mperaza0714/sea_grant/Assembly/front_angled.png

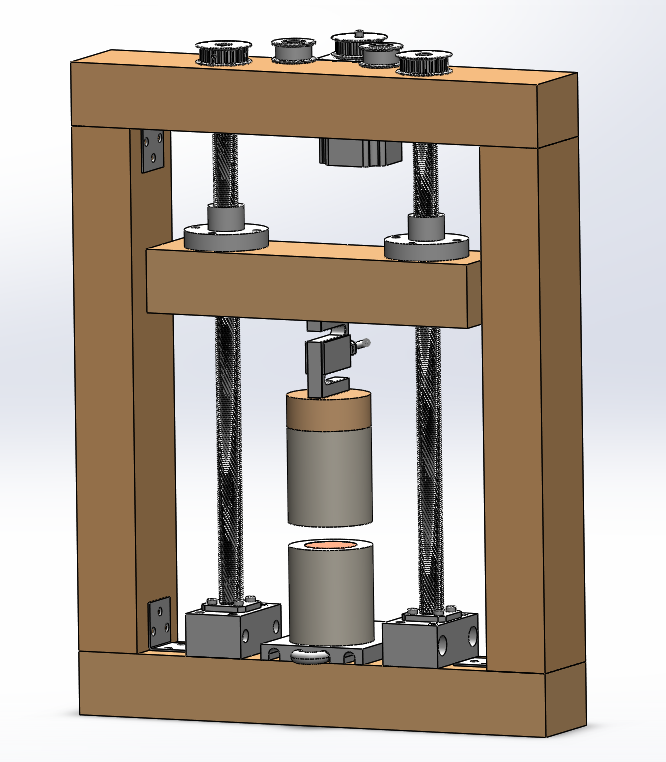
Assembly/front_angled.png
