mperaza0714/sea_grant/Assembly/rod_mount.png

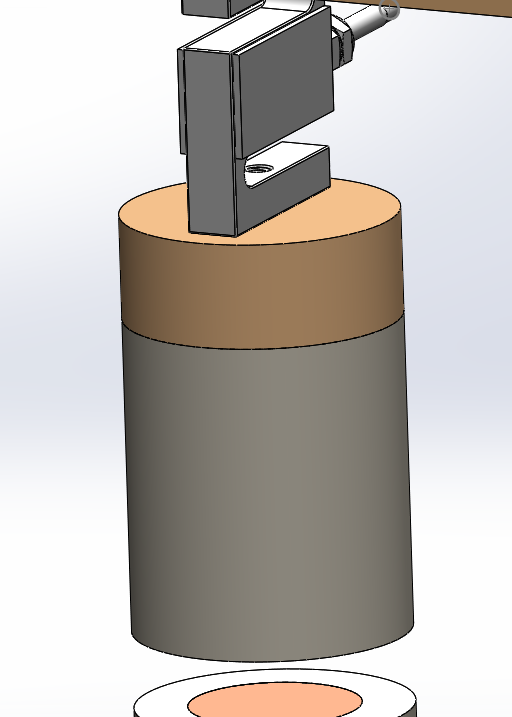
Assembly/rod_mount.png
