mperaza0714/sea_grant/Circuit Diagram.PNG

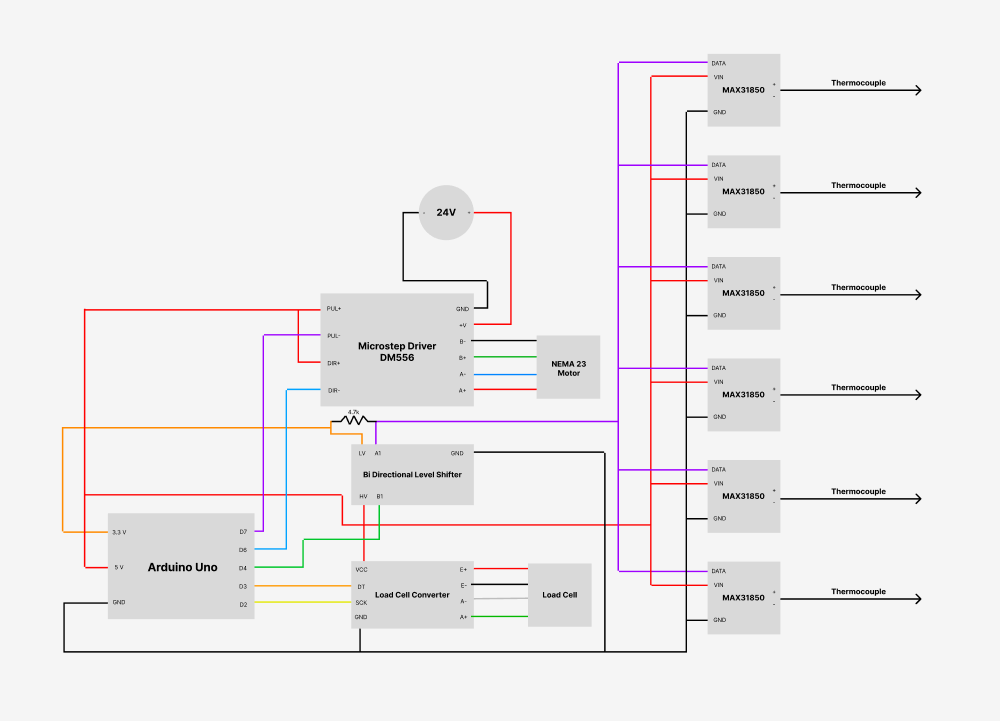
Circuit Diagram.PNG
