mperaza0714/sea_grant/Photos/Moving Platform.PNG

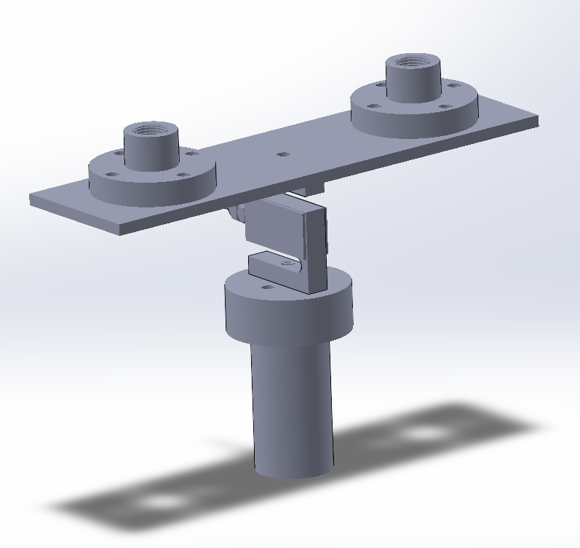
Photos/Moving Platform.PNG
