mperaza0714/sea_grant/Screenshot 2022-07-21 023725.png

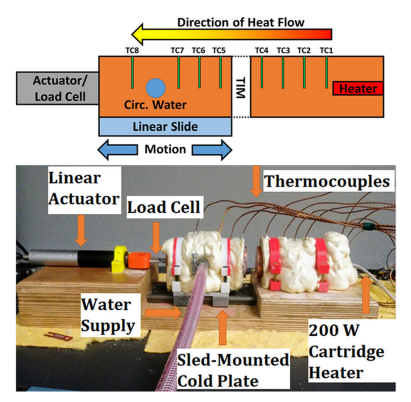
Screenshot 2022-07-21 023725.png
