mperaza0714/sea_grant/Thermal Interface Material Tester Experiments.docx

Thermal Interface Material Tester Experiments

I. Thermal Conductivity of materials given varying Pressure
  a. The material will be subject to varying pressures that can be repeated over several cycles to determine if there is a change in Thermal Conductivity given repeated usage of the material.
II. Thermal Conductivity of materials given static Pressure over Time
  a. Static pressure will be applied to the material where the Thermal Conductivity can be measured over time.
III. Compression Test
  a. Determines a materials behavior under applied loads. Can be used to find yield strength and other material properties.
