mperaza0714/sea_grant/Assembly/frame.SLDASM

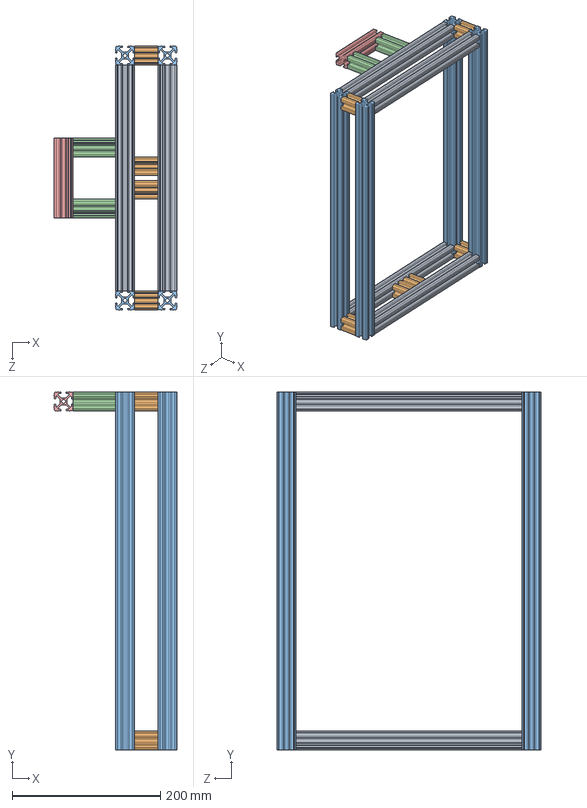
[picture p6: CAD file, 2022-09-02]
Assembly/frame.SLDASM
165.4 x 482.6 x 355.6 mm
T-Slotted Framing_baselength x 4
T-Slotted Framing_basewidth x 6
T-Slotted Framing_height x 4
T-Slotted Framing_motor_width x 2
T-Slotted Framing_motor_length
