mperaza0714/sea_grant/Assembly/moving_platform.SLDASM

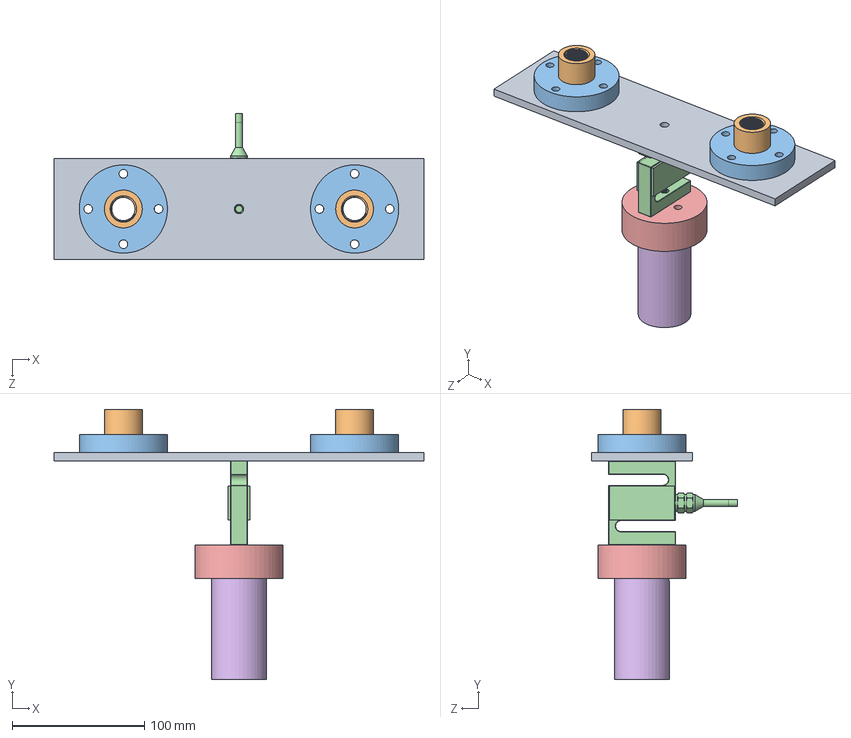
[picture p7: CAD file, 2022-09-02]
Assembly/moving_platform.SLDASM
279.4 x 204.0 x 110.2 mm
moving_platform
3-4_ScrewNut x 2
3-4_ScrewFlange x 2
3487N268_Force Sensor
rod_top
aluminum_rod_top
