mperaza0714/sea_grant/Assembly/cooling_system.SLDASM

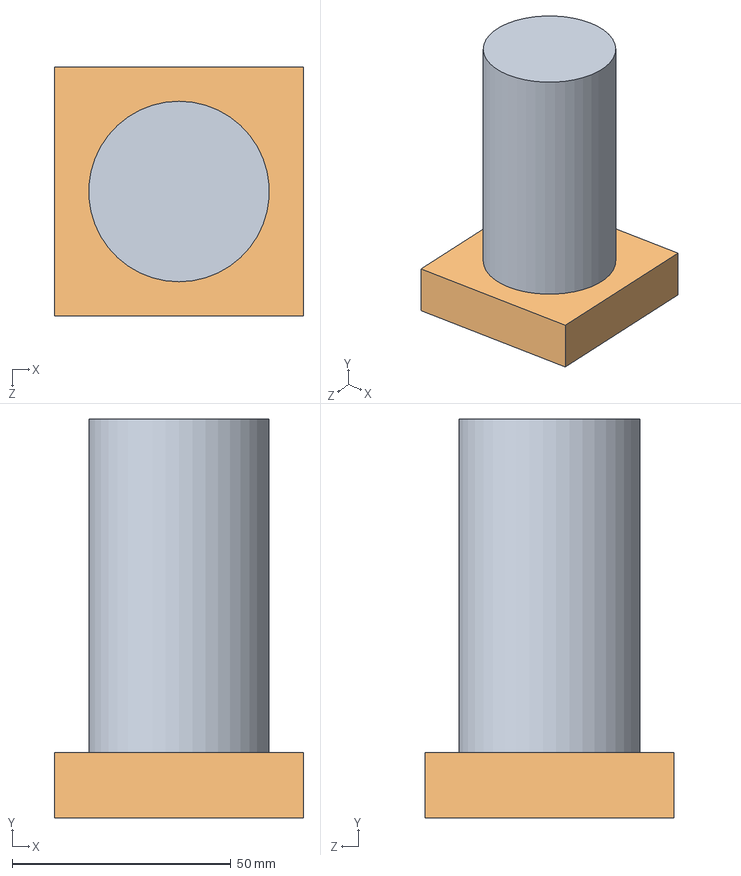
[picture p8: CAD file, 2022-09-02]
Assembly/cooling_system.SLDASM
57.0 x 91.2 x 57.0 mm
aluminum_rod_bottom
cold_plate
