mperaza0714/sea_grant/Assembly/insulated_rod.SLDASM

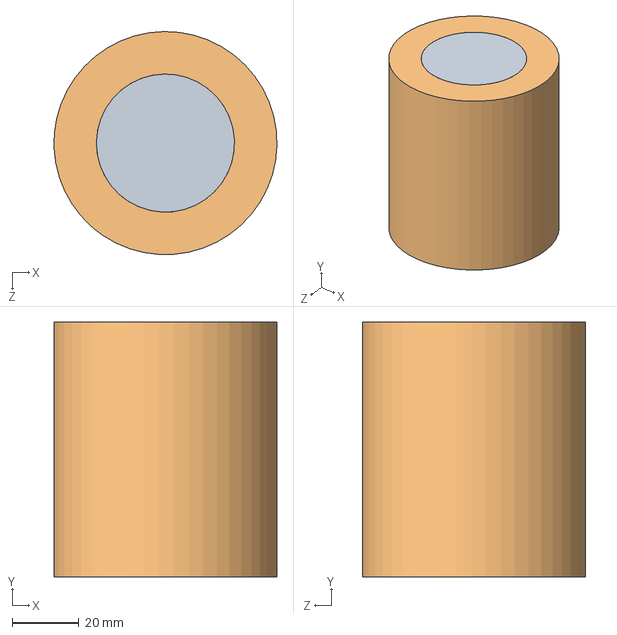
[picture p9: CAD file, 2022-06-21]
Assembly/insulated_rod.SLDASM
66.6 x 76.2 x 66.6 mm
copper_rod
insulation
