mperaza0714/sea_grant/Assembly/Waterjet/moving_platform.DXF

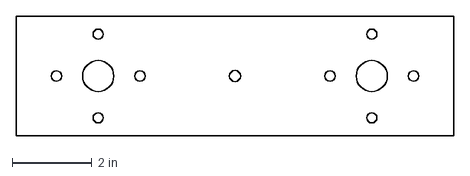
[picture p10: CAD file, 2022-09-02]
Assembly/Waterjet/moving_platform.DXF
11.0 x 3.00 in
