mperaza0714/sea_grant/Assembly/Waterjet/lead_shaft_support.DXF

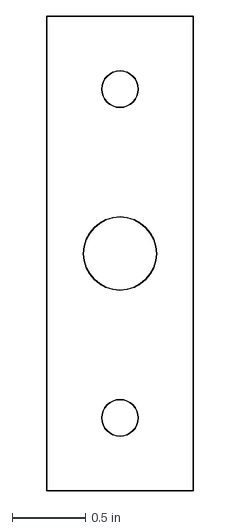
[picture p11: CAD file, 2022-09-02]
Assembly/Waterjet/lead_shaft_support.DXF
1.00 x 3.25 in
