mperaza0714/sea_grant/Assembly/Waterjet/BearingMount.DXF

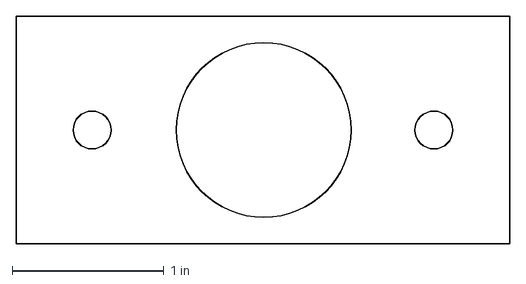
[picture p12: CAD file, 2022-09-02]
Assembly/Waterjet/BearingMount.DXF
3.25 x 1.50 in
