mperaza0714/sea_grant/Assembly/T-Slotted Framing_motor_length.SLDPRT

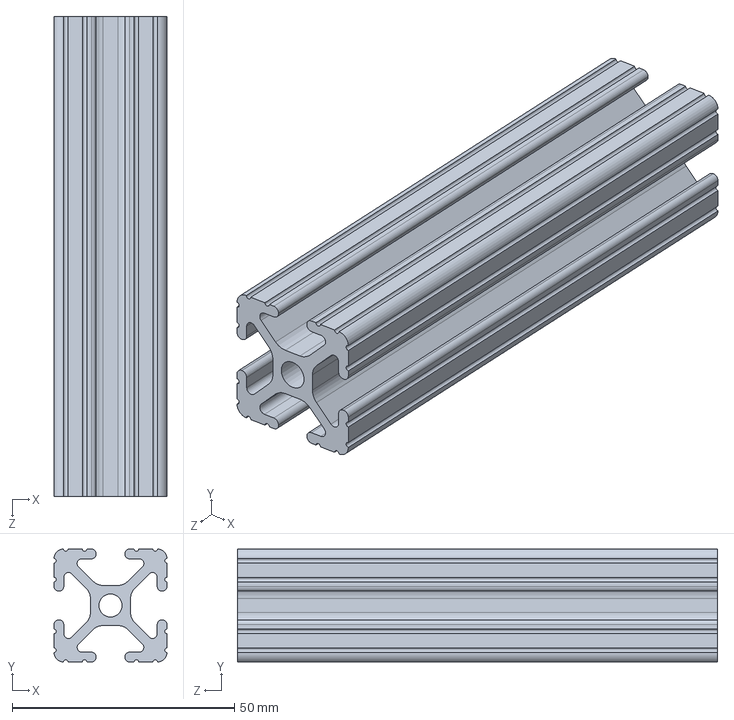
[picture p13: CAD file, 2022-09-02]
Assembly/T-Slotted Framing_motor_length.SLDPRT
25.4 x 25.4 x 108.0 mm
