mperaza0714/sea_grant/Assembly/Waterjet/Motor_Mount.DXF

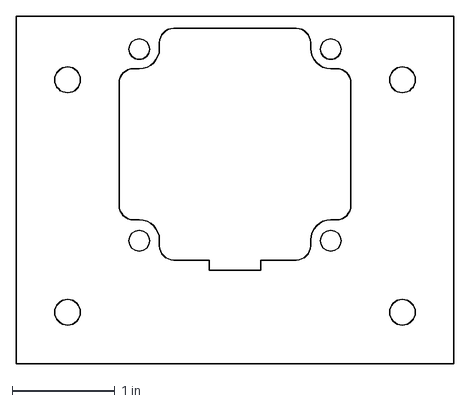
[picture p14: CAD file, 2022-09-02]
Assembly/Waterjet/Motor_Mount.DXF
4.25 x 3.38 in
