mperaza0714/sea_grant/Assembly/3-4_EndSupport.SLDPRT

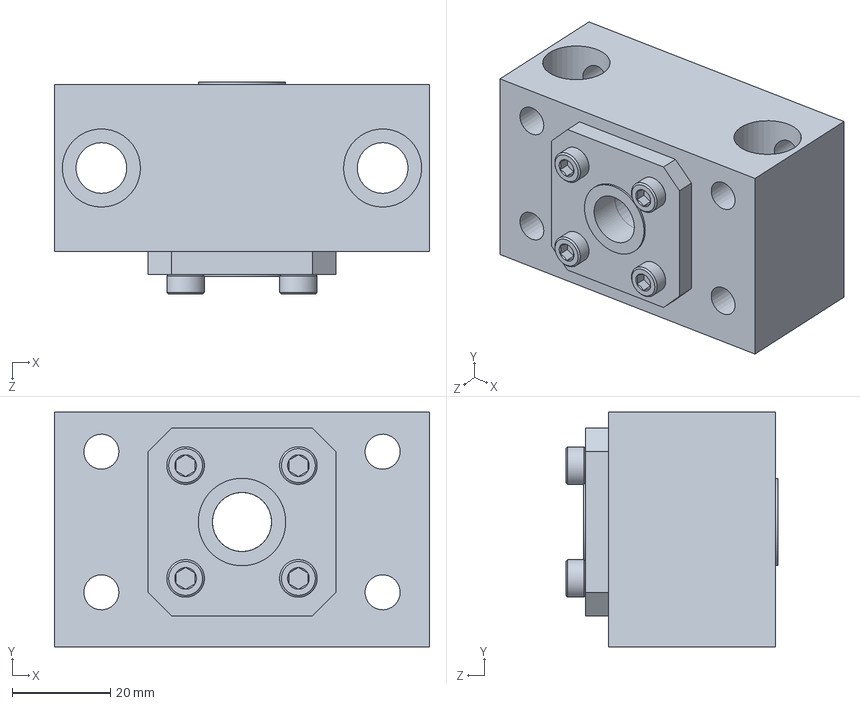
[picture p15: CAD file, 2022-09-02]
Assembly/3-4_EndSupport.SLDPRT
76.2 x 47.8 x 43.2 mm
