mperaza0714/sea_grant/Assembly/XL Series Timing Belt.SLDPRT

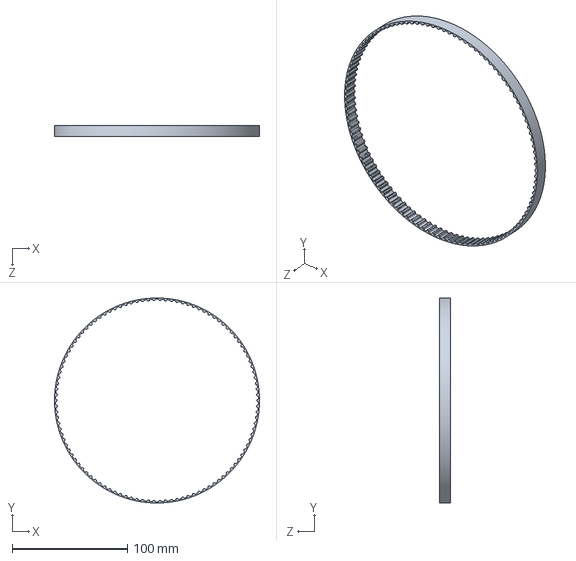
[picture p16: CAD file, 2022-09-02]
Assembly/XL Series Timing Belt.SLDPRT
177.9 x 177.9 x 9.53 mm
