mperaza0714/sea_grant/Assembly/Motor_Mount.SLDPRT

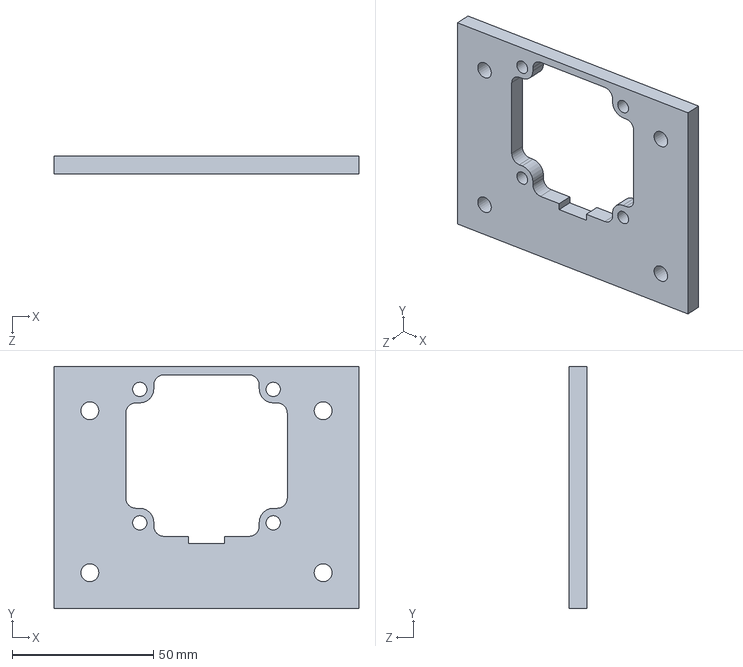
[picture p17: CAD file, 2022-09-02]
Assembly/Motor_Mount.SLDPRT
108.0 x 85.7 x 6.35 mm
