mperaza0714/sea_grant/Assembly/T-Slotted Framing_baselength.SLDPRT

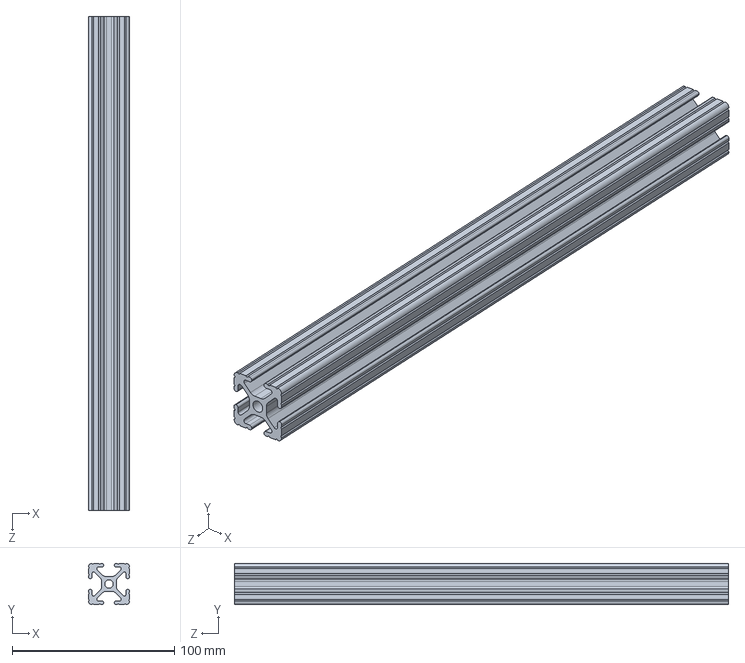
[picture p18: CAD file, 2022-09-02]
Assembly/T-Slotted Framing_baselength.SLDPRT
25.4 x 25.4 x 304.8 mm
