mperaza0714/sea_grant/Assembly/T-Slotted Framing_motor_width.SLDPRT

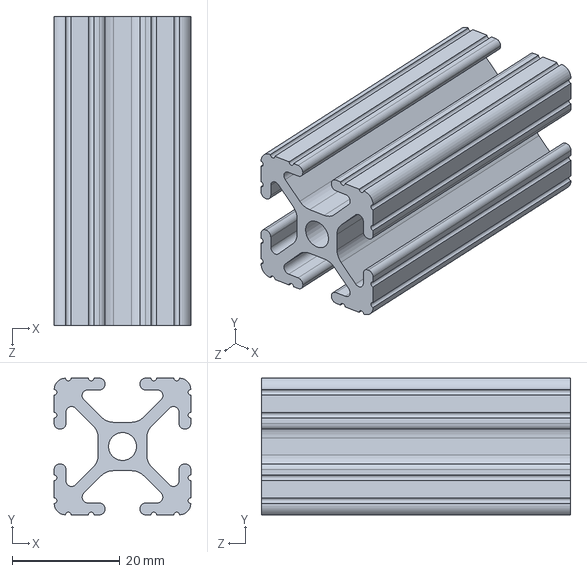
[picture p19: CAD file, 2022-09-02]
Assembly/T-Slotted Framing_motor_width.SLDPRT
25.4 x 25.4 x 57.4 mm
