mperaza0714/sea_grant/Assembly/aluminum_rod_bottom.SLDPRT

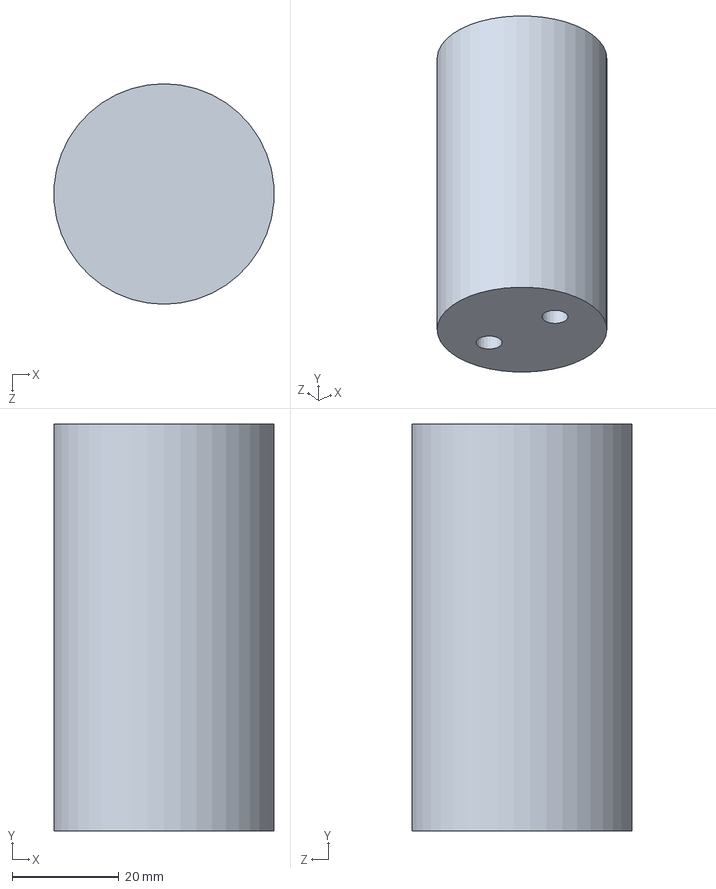
[picture p20: CAD file, 2022-09-02]
Assembly/aluminum_rod_bottom.SLDPRT
41.2 x 76.2 x 41.3 mm
