mperaza0714/sea_grant/Assembly/T-Slotted Framing_basewidth.SLDPRT

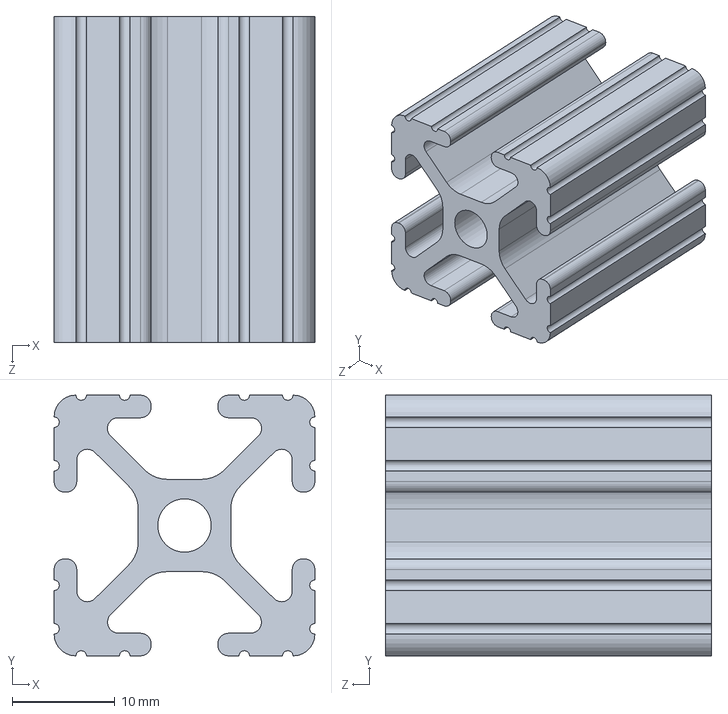
[picture p21: CAD file, 2022-09-02]
Assembly/T-Slotted Framing_basewidth.SLDPRT
25.4 x 25.4 x 31.7 mm
