mperaza0714/sea_grant/Assembly/Stepper Motor.SLDPRT

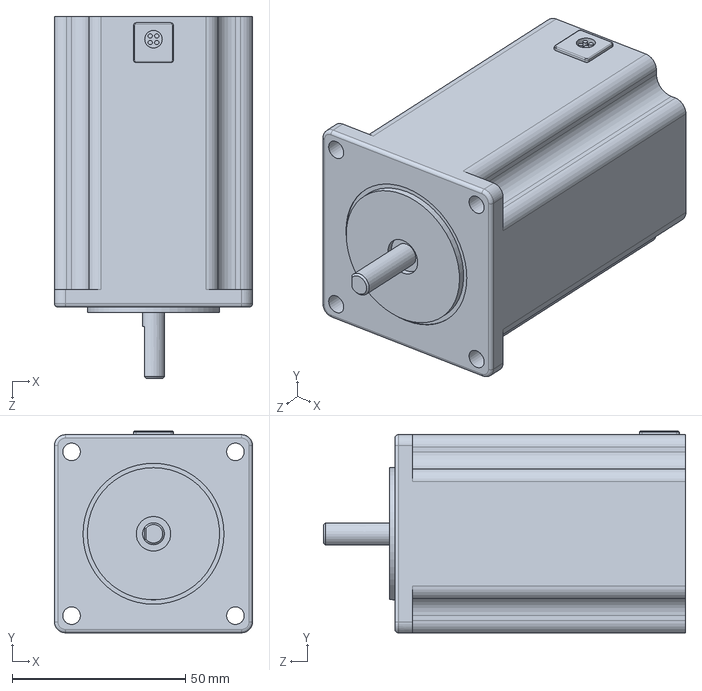
[picture p22: CAD file, 2022-09-02]
Assembly/Stepper Motor.SLDPRT
57.1 x 58.2 x 104.4 mm
