mperaza0714/sea_grant/Assembly/Timing Belt Pulley.SLDPRT

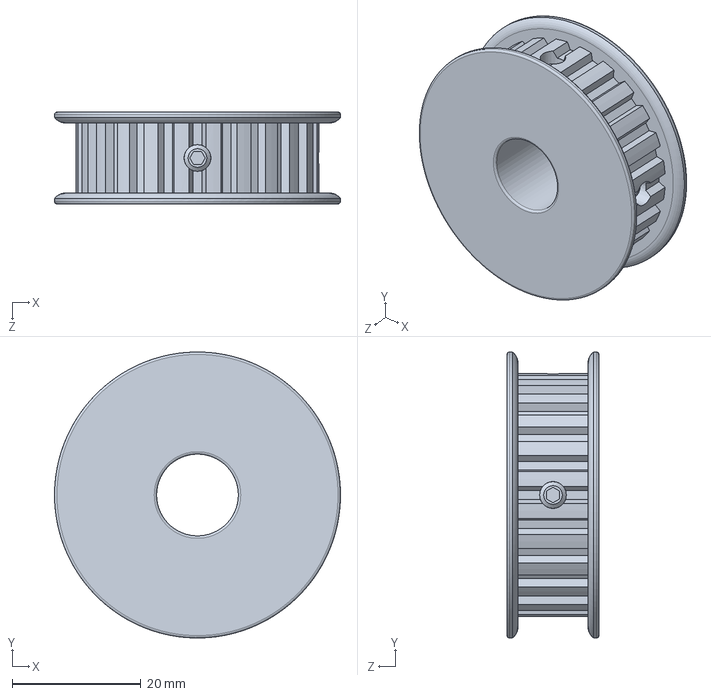
[picture p24: CAD file, 2022-09-02]
Assembly/Timing Belt Pulley.SLDPRT
44.5 x 44.4 x 14.3 mm
