mperaza0714/sea_grant/Assembly/aluminum_rod_top.SLDPRT

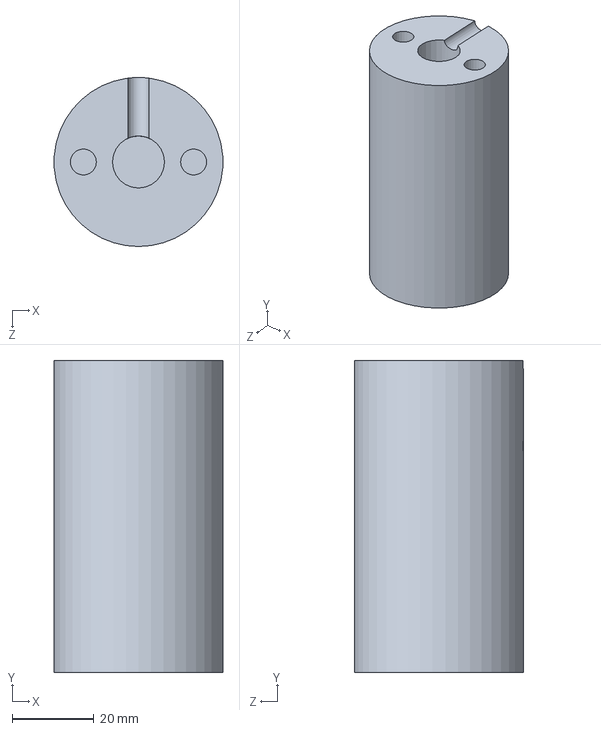
[picture p25: CAD file, 2022-09-02]
Assembly/aluminum_rod_top.SLDPRT
41.2 x 76.2 x 41.3 mm
