mperaza0714/sea_grant/Assembly/cold_plate.SLDPRT

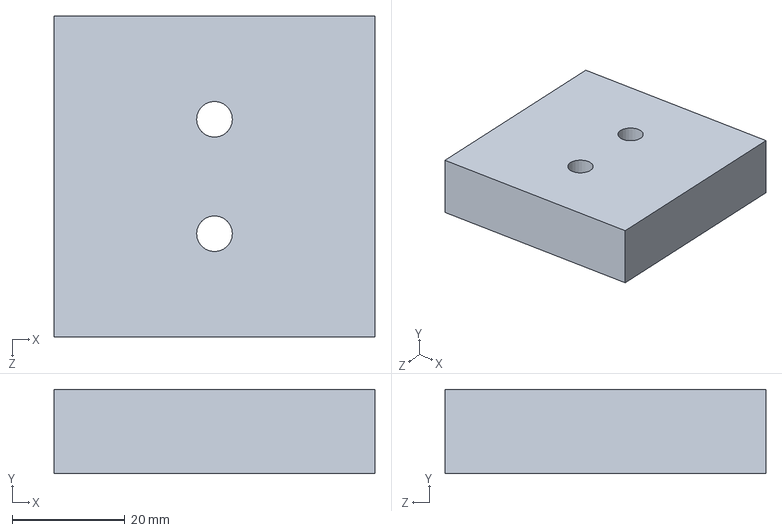
[picture p26: CAD file, 2022-09-02]
Assembly/cold_plate.SLDPRT
57.0 x 15.0 x 57.0 mm
