mperaza0714/sea_grant/Assembly/T-Slotted Framing_height.SLDPRT

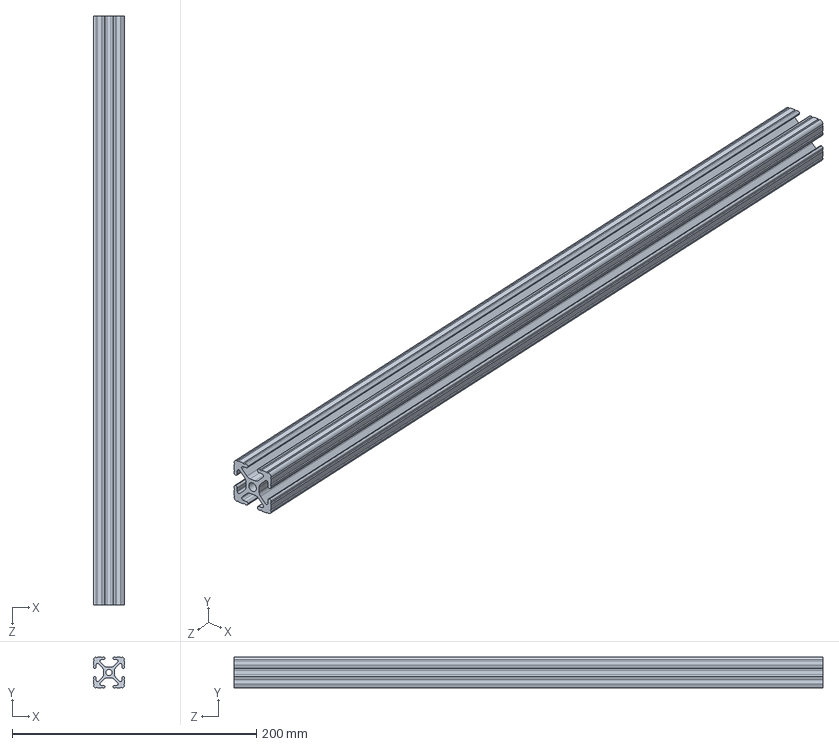
[picture p27: CAD file, 2022-09-02]
Assembly/T-Slotted Framing_height.SLDPRT
25.4 x 25.4 x 482.6 mm
