mperaza0714/sea_grant/Assembly/BearingMount.SLDPRT

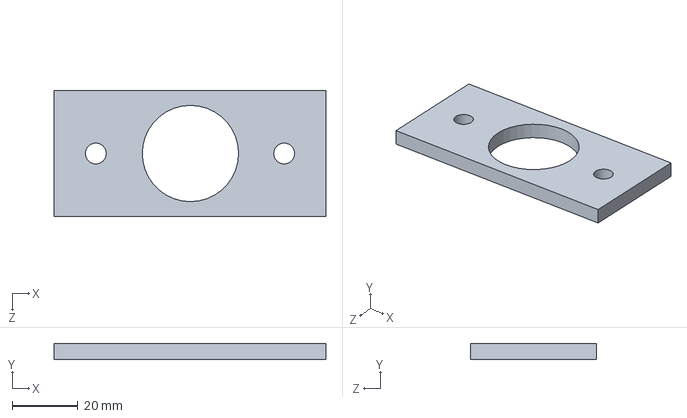
[picture p28: CAD file, 2022-09-02]
Assembly/BearingMount.SLDPRT
82.6 x 5.00 x 38.1 mm
