mperaza0714/sea_grant/Assembly/lead_shaft_support.SLDPRT

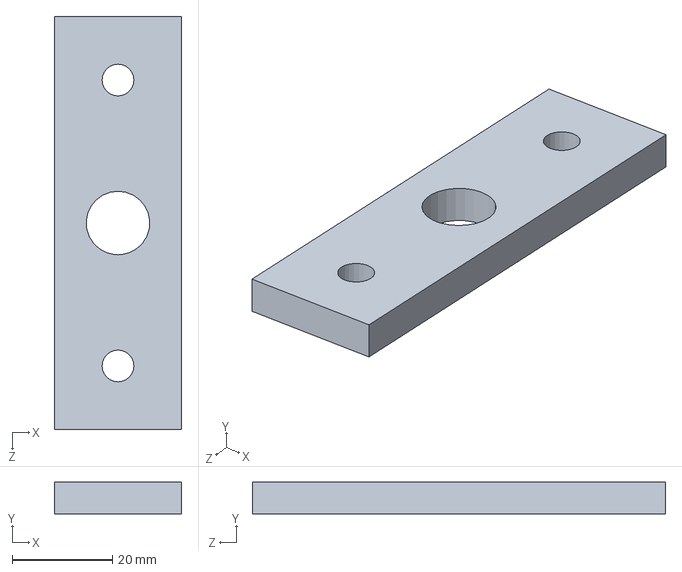
[picture p29: CAD file, 2022-09-02]
Assembly/lead_shaft_support.SLDPRT
25.4 x 6.35 x 82.5 mm
