mperaza0714/sea_grant/Assembly/Idler Pulley.SLDPRT

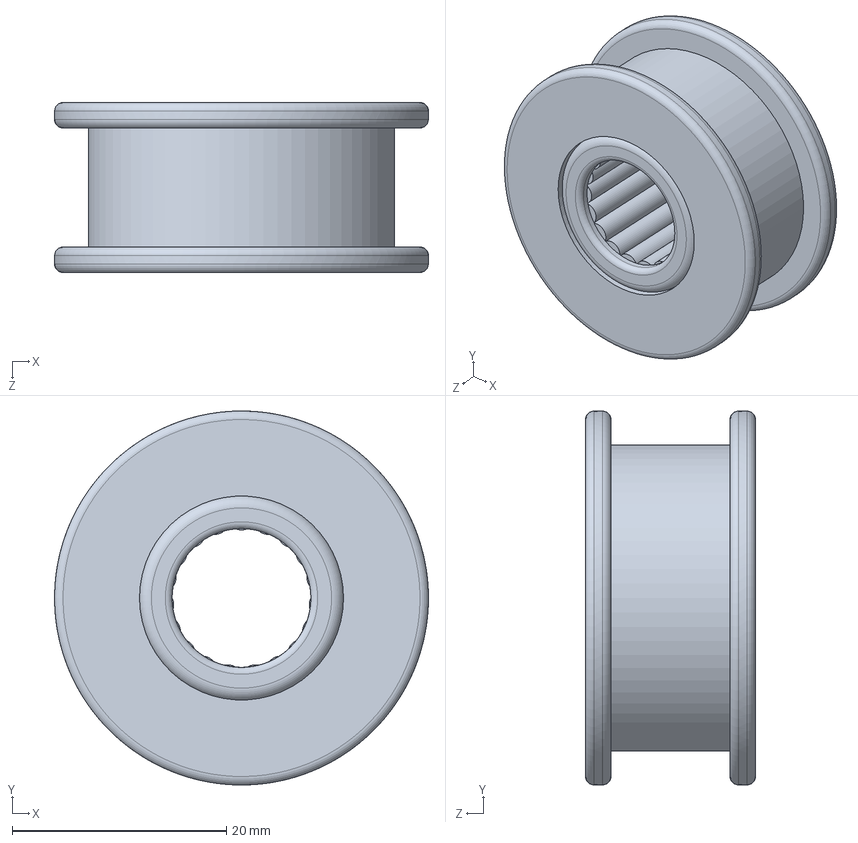
[picture p30: CAD file, 2022-09-02]
Assembly/Idler Pulley.SLDPRT
34.9 x 34.9 x 15.9 mm
