mperaza0714/sea_grant/Assembly/rod_top.SLDPRT

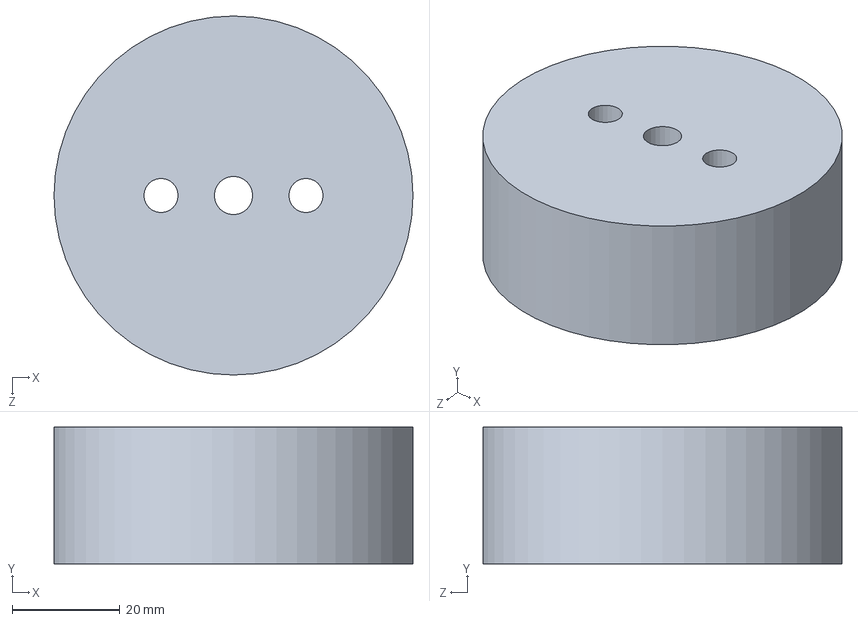
[picture p31: CAD file, 2022-09-02]
Assembly/rod_top.SLDPRT
66.7 x 25.4 x 66.7 mm
