mperaza0714/sea_grant/Assembly/support.SLDPRT

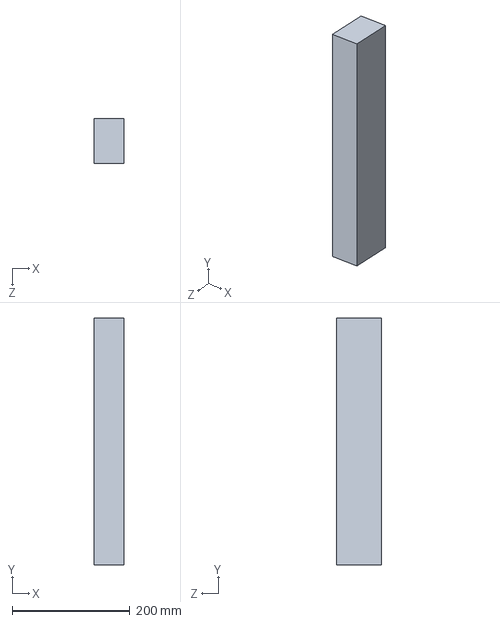
[picture p32: CAD file, 2022-06-21]
Assembly/support.SLDPRT
50.8 x 419.1 x 76.2 mm
