mperaza0714/sea_grant/Assembly/insulation.SLDPRT

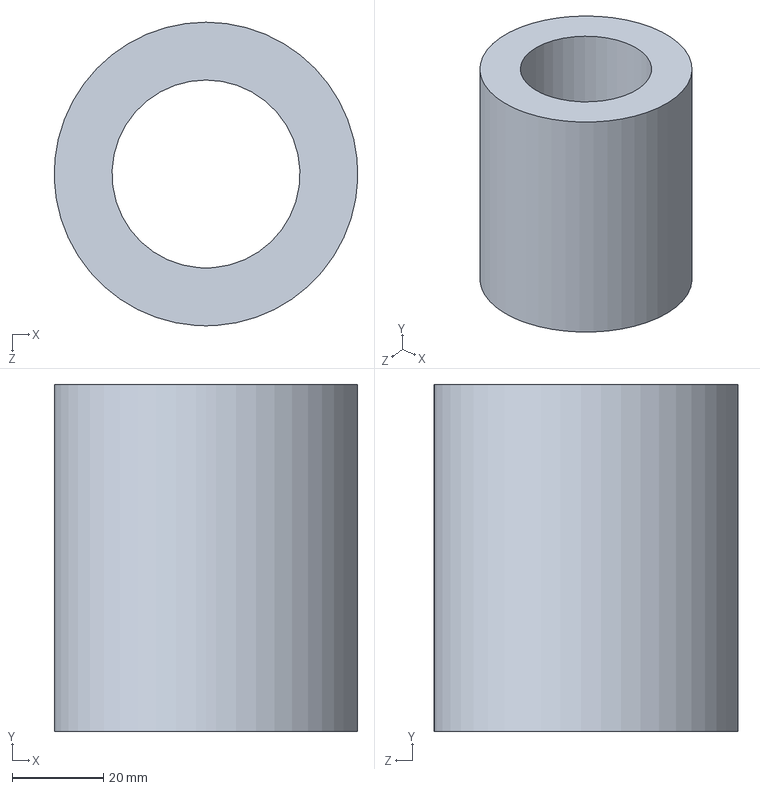
[picture p33: CAD file, 2022-06-21]
Assembly/insulation.SLDPRT
66.6 x 76.2 x 66.7 mm
