mperaza0714/sea_grant/Assembly/base.SLDPRT

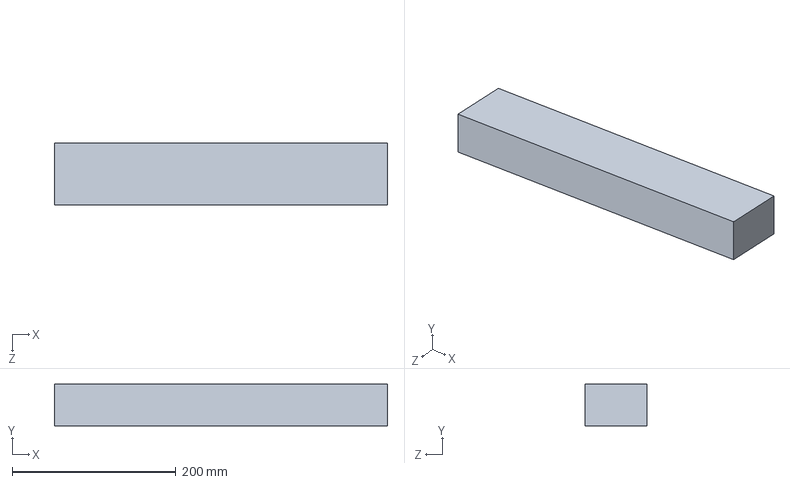
[picture p34: CAD file, 2022-06-21]
Assembly/base.SLDPRT
406.4 x 50.8 x 76.2 mm
