mperaza0714/sea_grant/Assembly/T-Slotted Framing.SLDPRT

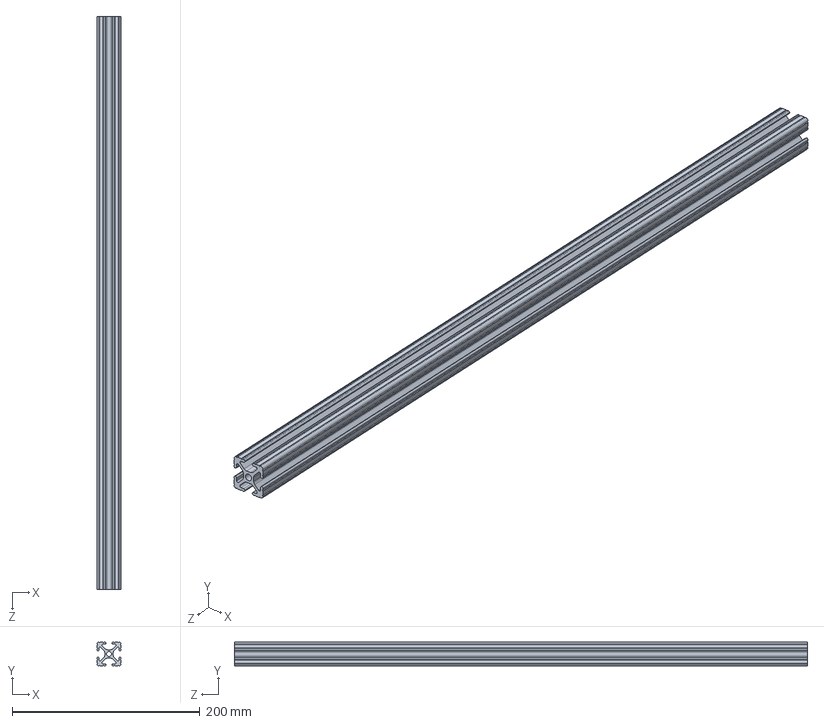
[picture p35: CAD file, 2022-06-21]
Assembly/T-Slotted Framing.SLDPRT
25.4 x 25.4 x 609.6 mm
