mperaza0714/sea_grant/Assembly/top.SLDPRT

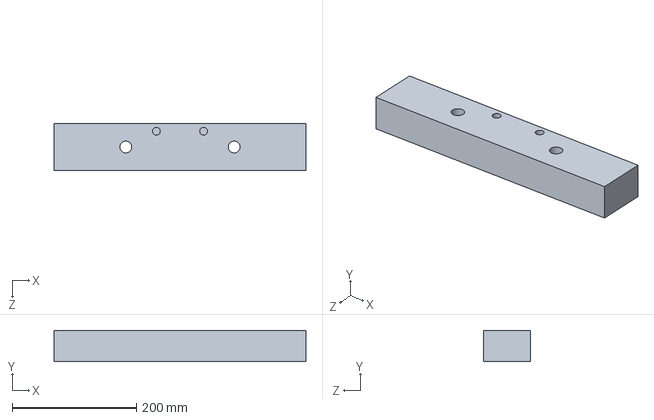
[picture p36: CAD file, 2022-06-21]
Assembly/top.SLDPRT
406.4 x 50.8 x 76.2 mm
