mperaza0714/sea_grant/(list of files, cad)

Other CAD files:
Assembly/moving_platform-SGEDUCATION-4.SLDASM
Assembly/frame-SGEDUCATION-4.SLDASM
Assembly/cooling_system-SGEDUCATION-4.SLDASM
Assembly/aluminum_rod_bottom-SGEDUCATION-4.SLDPRT
Assembly/3-4_EndSupport-SGEDUCATION-4.SLDPRT
Assembly/rod_top-SGEDUCATION-4.SLDPRT
Assembly/T-Slotted Framing_baselength-SGEDUCATION-4.SLDPRT
Assembly/T-Slotted Framing_height-SGEDUCATION-4.SLDPRT
Assembly/Motor_Mount-SGEDUCATION-4.SLDPRT
Assembly/Timing Belt Pulley-SGEDUCATION-4.SLDPRT
Assembly/Stepper Motor-SGEDUCATION-4.SLDPRT
Assembly/cold_plate-SGEDUCATION-4.SLDPRT
Assembly/Motor Timing Belt Pulley-SGEDUCATION-4.SLDPRT
Assembly/T-Slotted Framing_basewidth-SGEDUCATION-4.SLDPRT
Assembly/T-Slotted Framing_motor_length-SGEDUCATION-4.SLDPRT
Assembly/Idler Pulley-SGEDUCATION-4.SLDPRT
Assembly/aluminum_rod_top-SGEDUCATION-4.SLDPRT
Assembly/XL Series Timing Belt-SGEDUCATION-4.SLDPRT
Assembly/T-Slotted Framing_motor_width-SGEDUCATION-4.SLDPRT
Assembly/copper_rod.SLDPRT
Assembly/1277N765_Corrosion-Resistant Timing Belt Pulley.SLDPRT
Assembly/17715A43_Zinc-Plated Steel Corner Bracket.SLDPRT
Assembly/3-4_LeadScrew-SGEDUCATION-4.SLDPRT
Assembly/3-4_LeadScrew.SLDPRT
Assembly/3-4_ScrewFlange-SGEDUCATION-4.SLDPRT
Assembly/3-4_ScrewFlange.SLDPRT
Assembly/3-4_ScrewNut-SGEDUCATION-4.SLDPRT
Assembly/3-4_ScrewNut.SLDPRT
Assembly/3487N268_Force Sensor-SGEDUCATION-4.SLDPRT
Assembly/3487N268_Force Sensor.SLDPRT
Assembly/35035K32_Cold Plate.SLDPRT
Assembly/47065T411_T-Slotted Framing.SLDPRT
Assembly/Schematics/3-4_LeadScrew.SLDDRW
Assembly/Schematics/Motor_Mount.SLDDRW
Assembly/Schematics/T-Slotted Framing_baselength.SLDDRW
Assembly/Schematics/T-Slotted Framing_basewidth.SLDDRW
Assembly/Schematics/T-Slotted Framing_height.SLDDRW
Assembly/Schematics/T-Slotted Framing_motor_length.SLDDRW
Assembly/Schematics/T-Slotted Framing_motor_width.SLDDRW
Assembly/Schematics/lead_shaft_support.SLDDRW
Assembly/Schematics/moving_platform.SLDDRW
Assembly/Schematics/rod_top.SLDDRW
Assembly/lead_nut-SGEDUCATION-4.SLDASM
Assembly/lead_nut.SLDASM
Assembly/lead_screw_system-SGEDUCATION-4.SLDASM
Assembly/lead_screw_system.SLDASM
Assembly/moving_platform-SGEDUCATION-4.SLDPRT
Assembly/moving_platform.SLDPRT
