mperaza0714/sea_grant/Assembly/back_angled.png

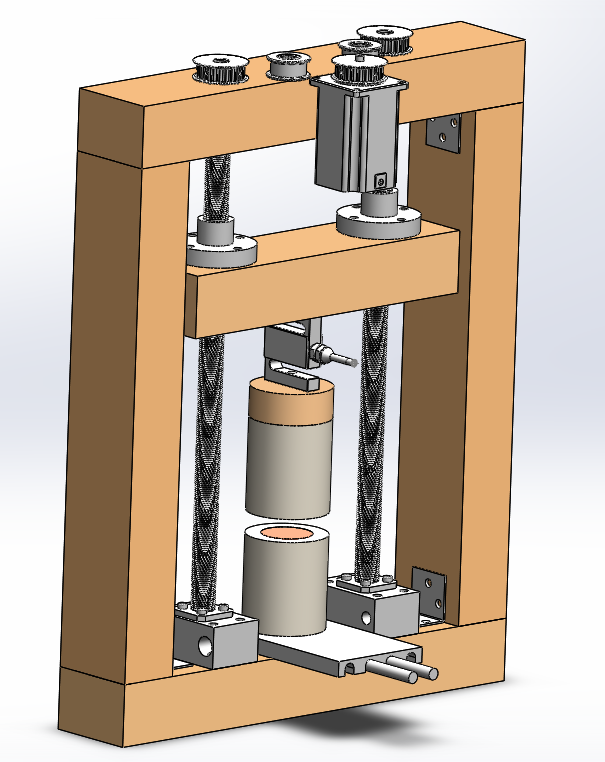
Assembly/back_angled.png
