mperaza0714/sea_grant/Assembly/top_angled.png

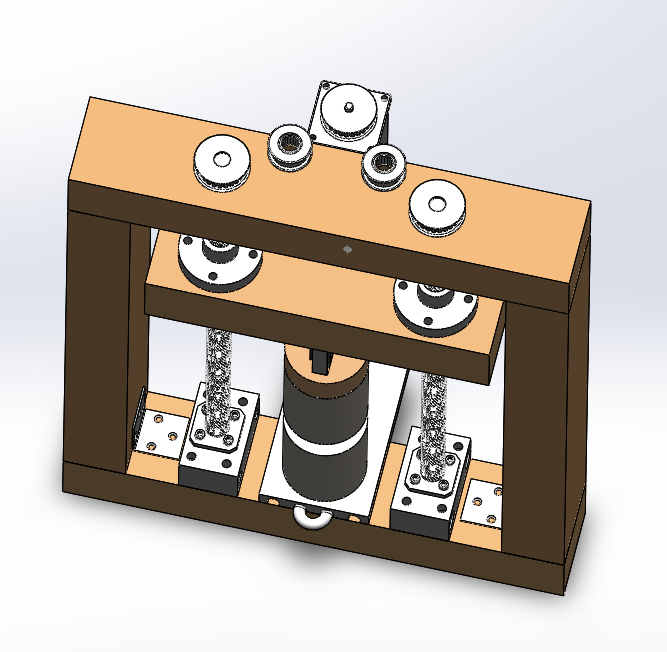
Assembly/top_angled.png
