mperaza0714/sea_grant/Part Specs/op_amp_wiring.jpg

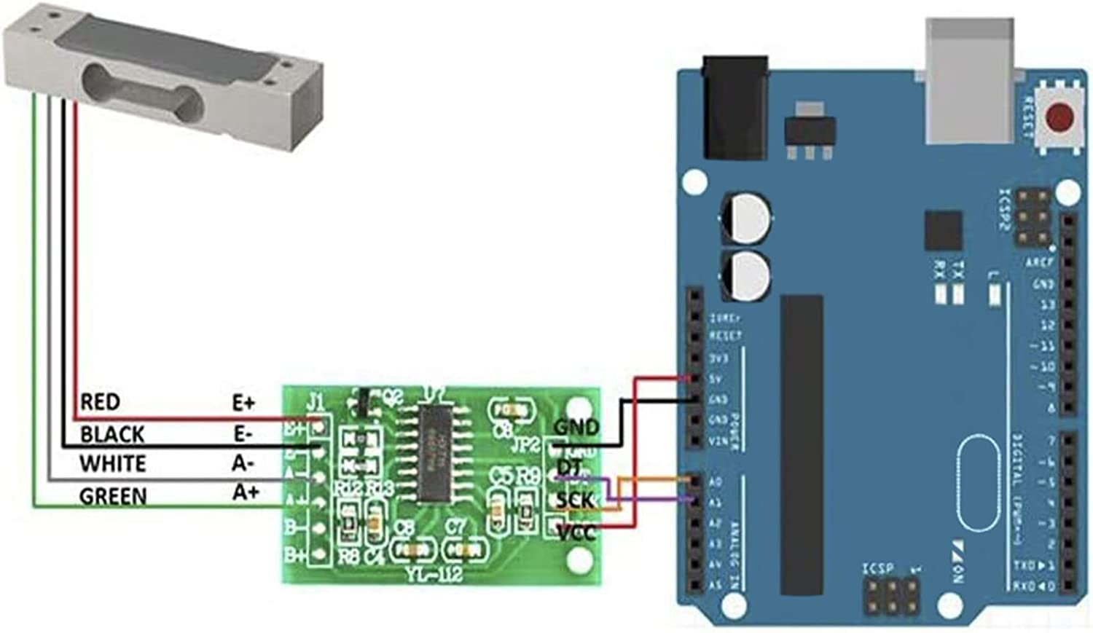
Part Specs/op_amp_wiring.jpg
