mperaza0714/sea_grant/Assembly/Schematics/PDF/3-4_LeadScrew - Sheet1.pdf

B

B

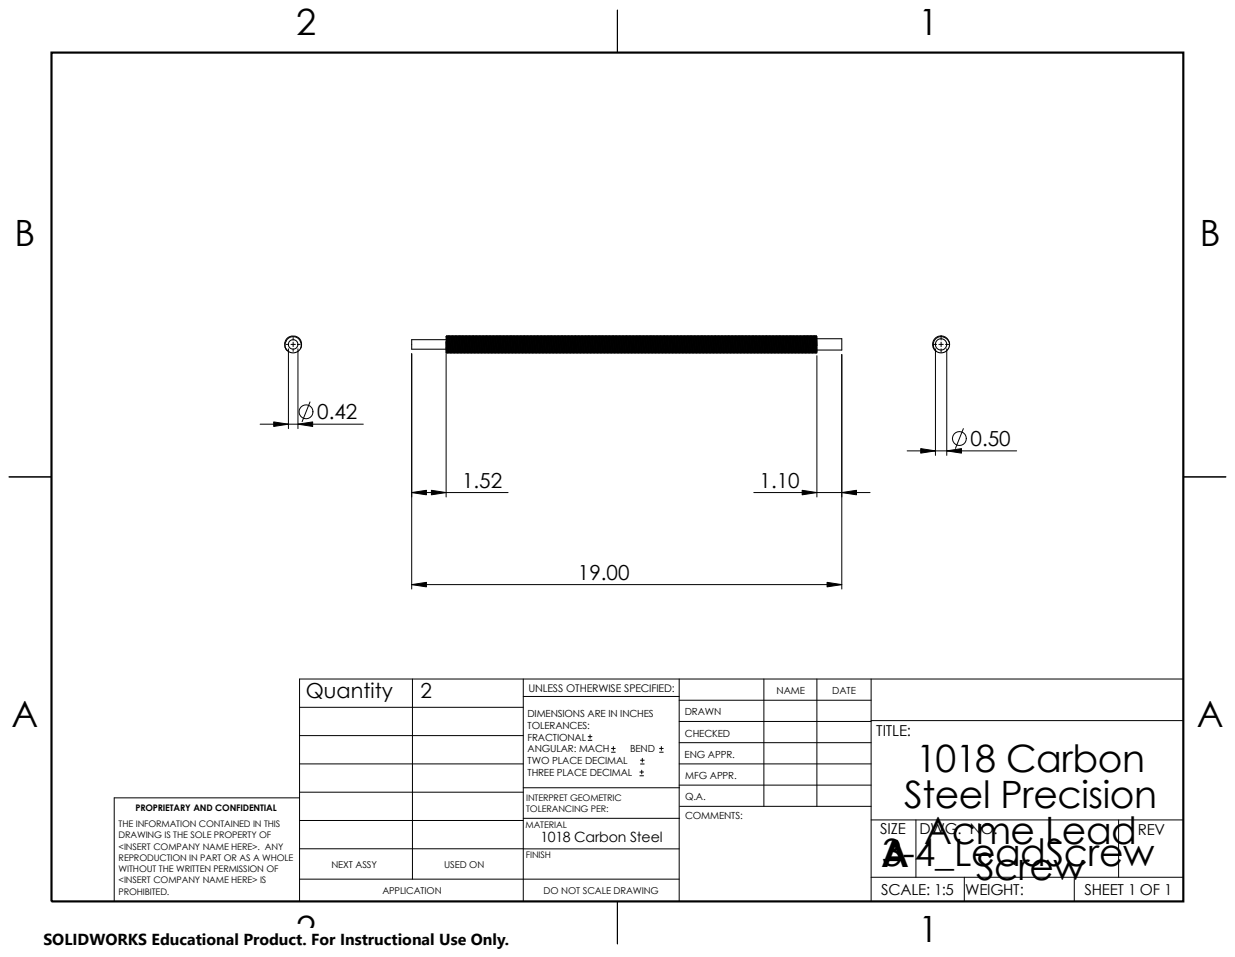
[picture p44: page 1]
1018 Carbon Steel; 3-4_LeadScrew Screw; SHEET 1 OF 1; SCALE: 1:5; WEIGHT:; DWG. NO.; REV; SIZE; TITLE:; NAME; DATE; COMMENTS:; FINISH; MATERIAL; Acme Lead; INTERPRET GEOMETRIC; Steel Precision; NEXT ASSY; 1018 Carbon; USED ON; APPLICATION; Quantity

UNLESS OTHERWISE SPECIFIED:

DIMENSIONS ARE IN INCHES TOLERANCES: FRACTIONAL ANGULAR: MACH BEND TWO PLACE DECIMAL THREE PLACE DECIMAL | DRAWN

CHECKED
ENG APPR.
MFG APPR.

TOLERANCING PER: | Q.A.

PROPRIETARY AND CONFIDENTIAL
THE INFORMATION CONTAINED IN THIS
DRAWING IS THE SOLE PROPERTY OF
<INSERT COMPANY NAME HERE>. ANY
REPRODUCTION IN PART OR AS A WHOLE
WITHOUT THE WRITTEN PERMISSION OF
<INSERT COMPANY NAME HERE> IS
PROHIBITED.

DO NOT SCALE DRAWING

SOLIDWORKS Educational Product. For Instructional Use Only.
