mperaza0714/sea_grant/Assembly/Schematics/PDF/lead_shaft_support - Sheet1.pdf

B | B

2

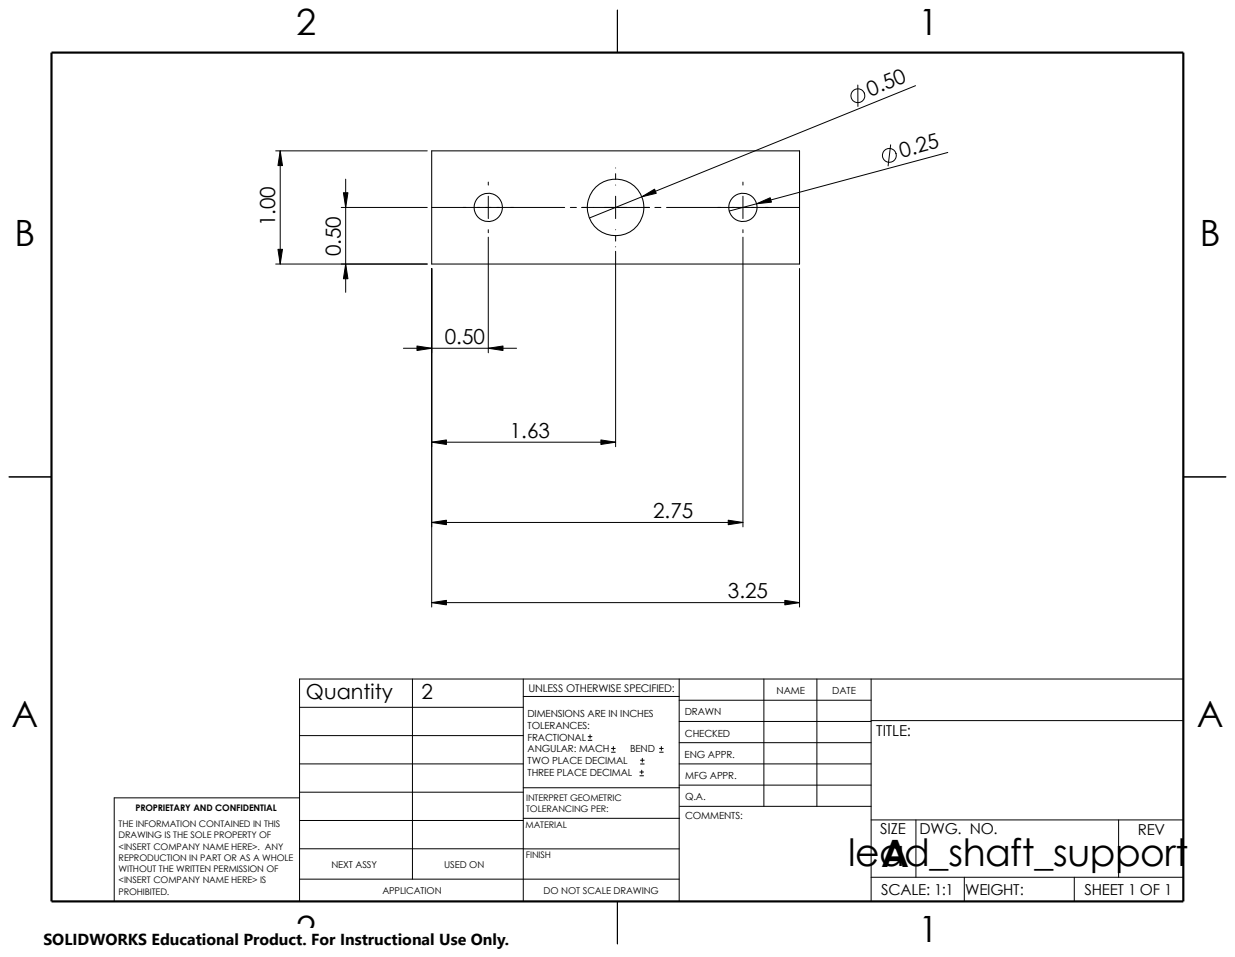
[picture p45: page 1]
lead_shaft_support; COMMENTS:; INTERPRET GEOMETRIC; PROPRIETARY AND CONFIDENTIAL; TOLERANCING PER:

Quantity | 2 | UNLESS OTHERWISE SPECIFIED: | | NAME | DATE

DIMENSIONS ARE IN INCHES TOLERANCES: FRACTIONAL ANGULAR: MACH BEND TWO PLACE DECIMAL THREE PLACE DECIMAL | DRAWN

CHECKED | | | TITLE:

ENG APPR.
MFG APPR.

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

MATERIAL | | SIZE A | DWG. NO. | REV

NEXT ASSY | USED ON | FINISH

APPLICATION | DO NOT SCALE DRAWING | | SCALE: 1:1 | WEIGHT: | SHEET 1 OF 1

SOLIDWORKS Educational Product. For Instructional Use Only.
