mperaza0714/sea_grant/Assembly/Schematics/PDF/T-Slotted Framing_height - Shee.pdf

B | B

2

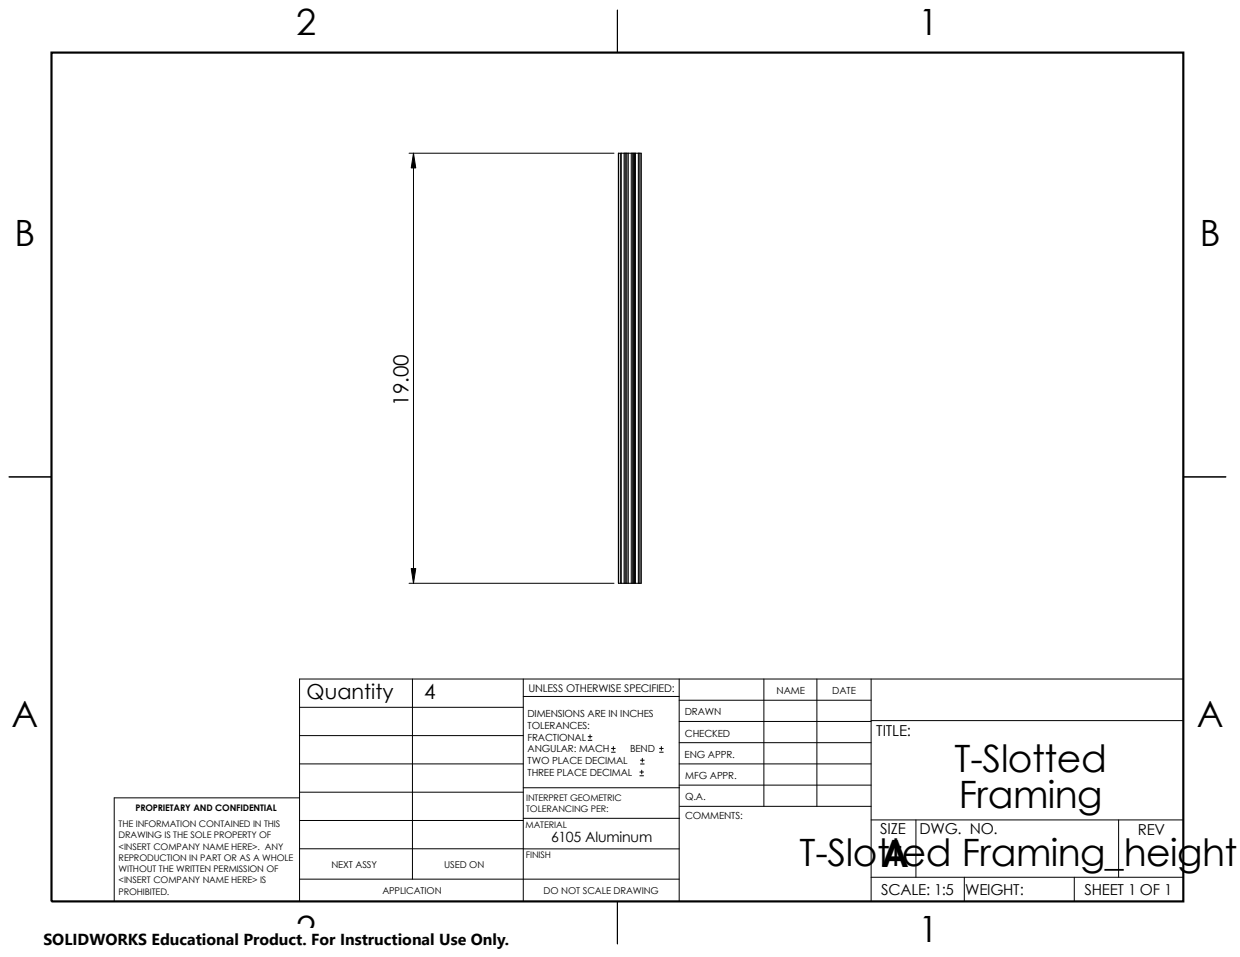
[picture p48: page 1]
Framing T-Slotted Framing_height; SHEET 1 OF 1; SCALE: 1:5; WEIGHT:; DWG. NO.; REV; SIZE; TITLE:; NAME; DATE; COMMENTS:; FINISH; 6105 Aluminum; T-Slotted; MATERIAL; USED ON; APPLICATION; PROPRIETARY AND CONFIDENTIAL; TOLERANCING PER:; NEXT ASSY; Quantity

UNLESS OTHERWISE SPECIFIED:

DIMENSIONS ARE IN INCHES TOLERANCES: FRACTIONAL ANGULAR: MACH BEND TWO PLACE DECIMAL THREE PLACE DECIMAL | DRAWN

CHECKED
ENG APPR.
MFG APPR.

INTERPRET GEOMETRIC | Q.A.

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

DO NOT SCALE DRAWING

SOLIDWORKS Educational Product. For Instructional Use Only.
