mperaza0714/sea_grant/Arduino/ConstantSpeed/ConstantSpeed.ino

// ConstantSpeed.pde
// -*- mode: C++ -*-
//
// Shows how to run AccelStepper in the simplest,
// fixed speed mode with no accelerations
/// \author  Mike McCauley (mikem@airspayce.com)
// Copyright (C) 2009 Mike McCauley
// $Id: ConstantSpeed.pde,v 1.1 2011/01/05 01:51:01 mikem Exp mikem $

#include <AccelStepper.h>

//AccelStepper stepper; // Defaults to AccelStepper::FULL4WIRE (4 pins) on 2, 3, 4, 5
AccelStepper stepper(1,7,6);

void setup()
{  
   stepper.setMaxSpeed(3570);
   stepper.setSpeed(500);	 
}

void loop()
{  
   stepper.runSpeed();
}
