mperaza0714/sea_grant/(commit log)

2022-06-22 updated model
    [3487N268_Force Sensor.SLDPRT, Motor_Mount.SLDPRT, T-Slotted Framing_motor_length.SLDPRT, T-Slotted Framing_motor_width.SLDPRT, aluminum_rod_bottom.SLDPRT, aluminum_rod_top.SLDPRT, cold_plate.SLDPRT, cooling_system.SLDASM]
2022-07-05 new computer
    [3-4_LeadScrew.SLDDRW, 3-4_LeadScrew.SLDPRT, Motor_Mount.SLDDRW, T-Slotted Framing_baselength.SLDDRW, T-Slotted Framing_basewidth.SLDDRW, T-Slotted Framing_height.SLDDRW, T-Slotted Framing_motor_length.SLDDRW, T-Slotted Framing_motor_width.SLDDRW]
2022-07-12 stepper testr code
    [3-4_EndSupport.SLDPRT, 3-4_LeadScrew.SLDPRT, 3-4_ScrewFlange.SLDPRT, 3-4_ScrewNut.SLDPRT, 3487N268_Force Sensor.SLDPRT, Idler Pulley.SLDPRT, Motor Timing Belt Pulley.SLDPRT, Motor_Mount.SLDPRT]
2022-09-02 Final Update
    probs final update, hopefully has all changes
    [3-4_EndSupport-SGEDUCATION-4.SLDPRT, 3-4_EndSupport.SLDPRT, 3-4_LeadScrew-SGEDUCATION-4.SLDPRT, 3-4_LeadScrew.SLDPRT, 3-4_ScrewFlange-SGEDUCATION-4.SLDPRT, 3-4_ScrewFlange.SLDPRT, 3-4_ScrewNut-SGEDUCATION-4.SLDPRT, 3-4_ScrewNut.SLDPRT]
2022-09-21 Update Thermal Interface Material Tester Manual.docx
